jnahuel/Purity/03. Hardware/Generador de ozono/Images/Generador de ozono - Dorso.jpg

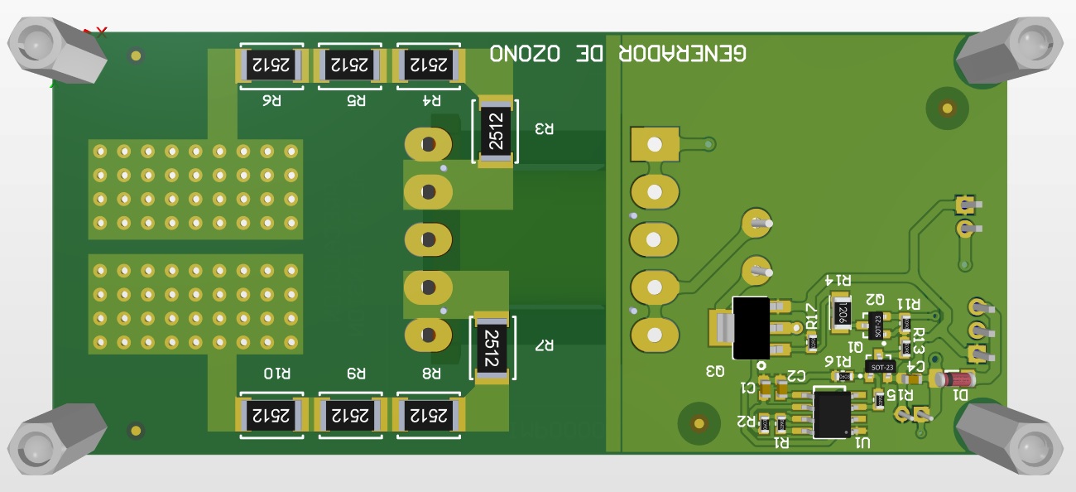
03. Hardware/Generador de ozono/Images/Generador de ozono - Dorso.jpg
