jnahuel/Purity/03. Hardware/Generador de ozono/Images/Generador de ozono - Frente.jpg

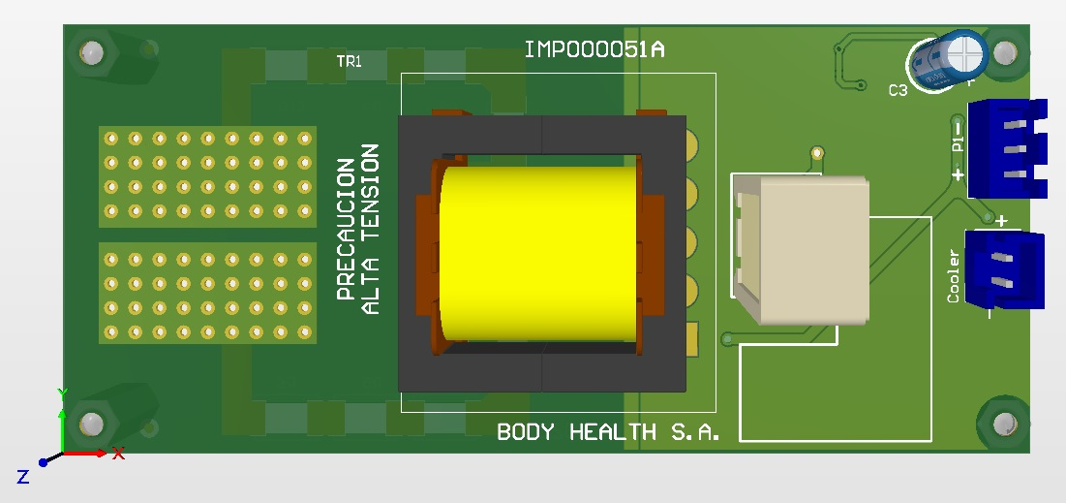
03. Hardware/Generador de ozono/Images/Generador de ozono - Frente.jpg
