jnahuel/Purity/01. Description/Medición de la generación de ozono.pdf

## Medición de la generación de ozono

Para poder calibrar la generación de ozono en los equipos Purity, se estableció el siguiente setup:

- Cavidad cerrada de 35cm x 35cm x 8,4cm. Contiene un volumen aproximado de 0,01m³
- Sensor de ozono “ULPSM-O3 968-046”
- Fuente de alimentación de 12V con 10W de potencia.
- Placa prototipo para generar ozono.

Por recomendaciones de la hoja de datos del sensor, se lo debe dejar precalentar 1 hora en el ambiente donde se realizará la medición, el cuál debe estar libre del gas a medir. Pasado este tiempo, se accionó el generador de ozono y se dejó el sistema en estas condiciones por otra hora, antes de tomar la medición.
El valor de referencia para un ambiente libre de ozono es de 1,45V. Al cabo de 4 mediciones, se obtuvo un valor promedio de 1,8v en el pin de salida del sensor. Esto significa una diferencia de 0,35v respecto de la referencia de tensión para un ambiente libre del gas en cuestión. La sensibilidad típica del sensor utilizado es de 30mV/PPM, con un valor mínimo de 15mV/PPM. Se tomará éste último como el valor del dispositivo, ya que arrojaría la peor condición posible. Por lo tanto, se tiene que:

# SSSSSSSSSSSSSSSSSSSSSSSS mmí mm mmmm = 15mmmm/PPPPPP DD DD DD mm = 350mmmm

Con lo que la concentración dentro de la caja de medición será de:

# CC CC ó mmáxx = DD DD DD mm SSSSSSSSSSSSSSSSSSSSSSSS mmí mm mmmm CC CC ó mmáxx = 350mmmm 15mmmm/PPPPPP CC ó mmáxx cc = 23PPPPPP

Para el peso molecular del gas ozono (48), se tiene la equivalencia

# 1PPPPPP = 1,96mmmm/mm3

Esto arroja que para el volumen de la caja, la cantidad de mili gramos producidos es:

# CC oo = 0,45mmmm

Contemplando el caso del ambiente standard para el cual está pensado el Purity, de 130mm3,

arroja una concentración de:

CC CC ó mmáxx | = 0,45mmmm 130mm3
CC CC ó mmáxx | = 0,0035 mmmm mm3

O, lo que es lo mismo:

# CC CC ó mmáxx = 0,00178PPPPPP

En conclusión, la máxima dosis de ozono que el equipo Purity es posible de generar, se encuentra muy por debajo del límite indicado por la TLV de 0,1PPM, para exposiciones prolongadas de 8 horas diarias. Por lo tanto, se concluye la seguridad de las personas presentes en el ambiente de trabajo del dispositivo.

Por otro lado, se observó que pasado un tiempo de 5’, en todas las mediciones, el sensor volvió a indicar el valor del ambiente previo a la contaminación por ozono, demostrando que es un gas inestable que no genera permanencia en el ambiente.
