jnahuel/Purity/02. Hospital/Comparation.pdf

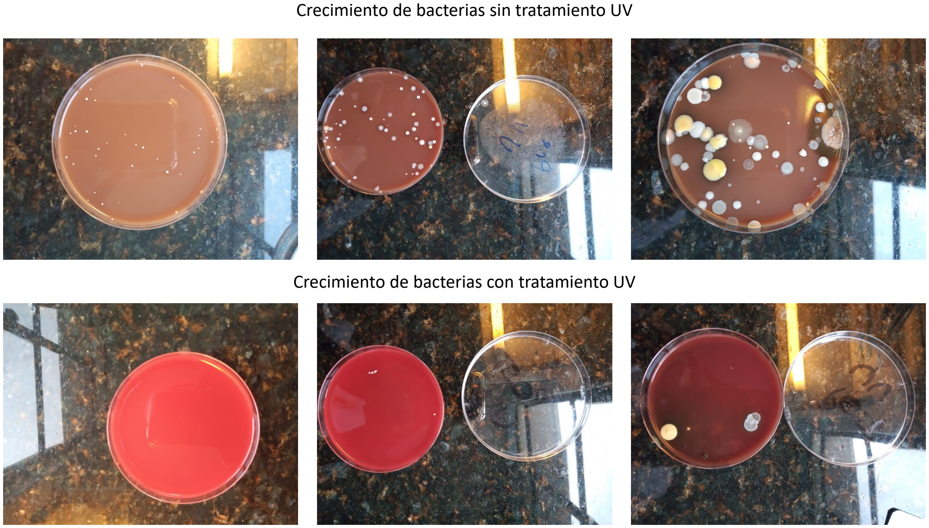
[picture p16: page 1]

Crecimiento de bacterias sin tratamiento UV

Crecimiento de bacterias con tratamiento UV

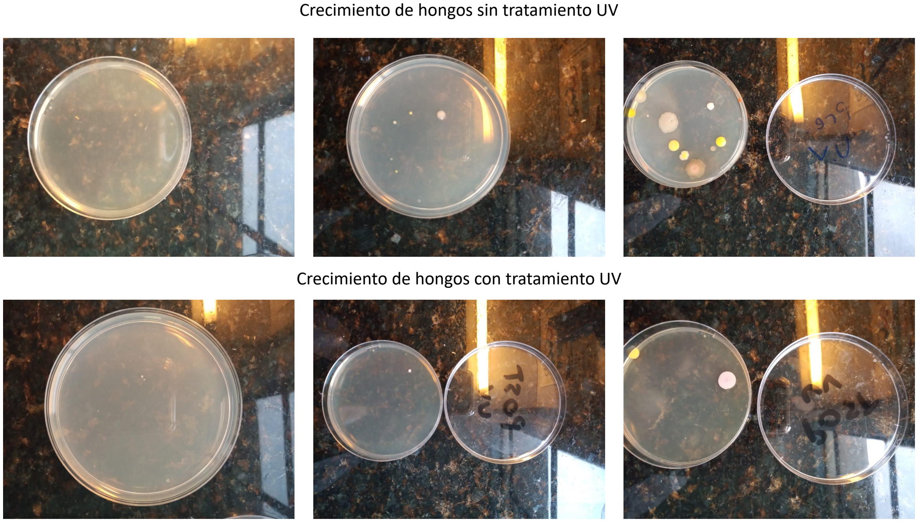
[picture p17: page 2]

Crecimiento de hongos sin tratamiento UV

Crecimiento de hongos con tratamiento UV
