jnahuel/Purity/03. Hardware/Display_Control_UV/Images/Display_Control_UV - 3D.jpg

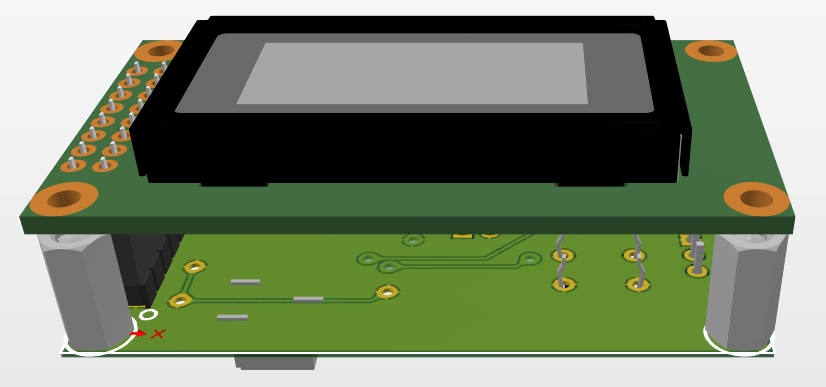
03. Hardware/Display_Control_UV/Images/Display_Control_UV - 3D.jpg
