jnahuel/Purity/03. Hardware/Generador de ozono/Images/Generador de ozono - 3D.jpg

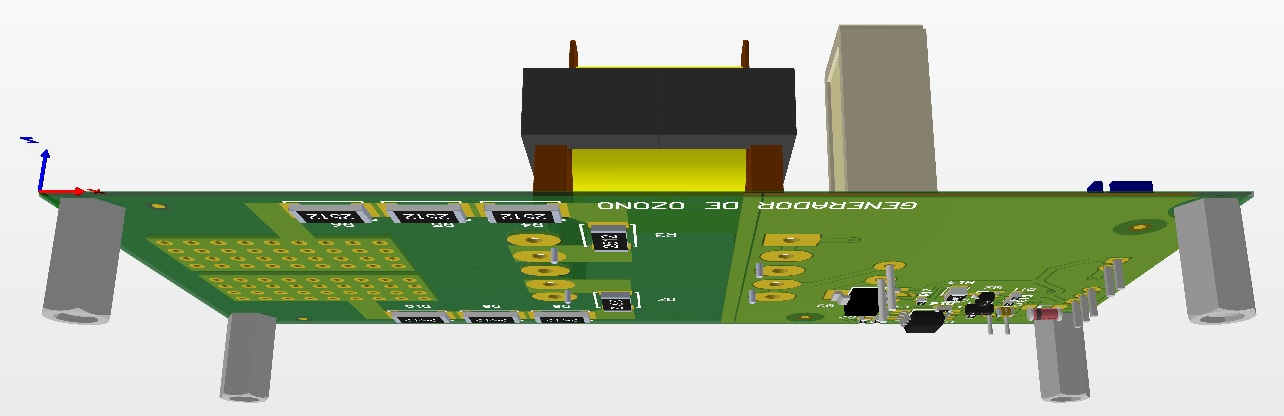
03. Hardware/Generador de ozono/Images/Generador de ozono - 3D.jpg
