jnahuel/Purity/03. Hardware/Display_Control_UV/Project Outputs for Display_Control_UV/Display_Control_UV.xlsx

Quantity | Designator | Value | Cod.DigiKey | Description | Comment | Fabricante | Cod.Fabricante | Footprint
2 | Balastro, Tubo |  | 450-1650-ND | Ejemplo | Boton para placa | TE Connectivity ALCOSWITCH Switches | 1825910-6 | TactButton
3 | C1, C2, C3 | 100nF | 399-7845-1-ND | CAP CER 0.1UF 50V X7R 0603 | 100nF | KEMET | C0603C104M5RACTU | C_0603
1 | D1 | FDLL4148 | FDLL4148CT-ND | DIODE GEN PURP 100V 200MA LL34/SOD80/MINI MELF | FDLL4148 | ON Semiconductor | FDLL4148 | SOD-80/MLL34
1 | J1 |  | S2011EC-03-ND | CONN HEADER VERT 6POS 2.54MM | DBM | Sullins Connector Solutions | PRPC003DAAN-RC | DBM
1 | OLED1 |  | S2011EC-08-ND | Header para la placa 8x2 OLED Character Display | OLED-08x02-4soportes | Sullins Connector Solutions | PRPC008DAAN-RC | OLED-ZocaloDoble
1 | OLED_BOM1 |  | - | 8x2 OLED Character Display | OLED-8x2-BOM | Winstar | WEH000802A-BPP5N0 | OLED-08x02-4soportes | <-- Por ahora se coloca en Body
1 | OLED_HEADER_BOM1 |  | S7111-ND | Header 8x2 | OLED-8x2-Header-BOM | Sullins Connector Solutions | PPPC082LFBN-RC
1 | P1 |  | 455-2248-ND | CONN HEADER XH TOP 3POS 2.5MM | IN_VCC | JST Sales America Inc. | B3B-XH-A(LF)(SN) | B3B-XH-A_3D
3 | R1, R3, R4 | 10K | 311-10KGRCT-ND | RES SMD 10K OHM 5% 1/10W 0603 | 10K | Yageo | RC0603JR-0710KL | R_0603
1 | R2 | 5K | 3361P-502GLFCT-ND | TRIMMER 5K OHM 0.5W GW TOP ADJ | 5K | Bourns Inc. | 3361P-1-502GLF | Preset_SMD
1 | U1 | MC9S08PA32AVLCR-32 | 568-15175-1-ND | S08 Microcontroller IC 8-Bit 20MHz 32KB (32K x 8) FLASH 32-LQFP (7x7) | MC9S08PA32AVLCR-32 | NXP | MC9S08PA32AVLCR | QFP7x7
1 | U2 |  | MC78M05BDTRKGOSCT-ND | IC REG LINEAR 5V 500MA DPAK | MC78M05 | ON Semiconductor | MC78M05BDTRKG | TO-252AA_N
