jnahuel/Purity/03. Hardware/Generador de ozono/Project Outputs for Generador de ozono/Generador de ozono.xls

Cod.Digikey | Cod.Fabricante | Description | Designator | Quantity
 | IMP000051A | Circuit Board, 2 Layers with mask and silk | BOM1 | 1
399-9042-1-ND | C0603C222M5RACTU | CAP CER 2200PF 50V X7R 0603 | C1 | 1
399-7842-1-ND | C0603C103M5RACTU | CAP CER 10000PF 50V X7R 0603 | C2 | 1
493-1058-ND | UVR1E220MDD | CAP ALUM 22UF 20% 25V RADIAL | C3 | 1
399-7845-1-ND | C0603C104M5RACTU | CAP CER 0.1UF 50V X7R 0603 | C4 | 1
455-2247-ND | B2B-XH-A(LF)(SN) | CONN HEADER XH TOP 2POS 2.5MM | Cooler | 1
FDLL4148CT-ND | FDLL4148 | DIODE GEN PURP 100V 200MA LL34/SOD80/MINI MELF | D1 | 1
 |  | Pad para terminar un camino - No es un componente | J1, J2 | 2
455-2248-ND | B3B-XH-A(LF)(SN) | CONN HEADER XH TOP 3POS 2.5MM | P1 | 1
MMBT2907A-FDICT-ND | MMBT2907A-7-F | TRANS PNP 60V 0.6A SOT23-3 | Q1 | 1
MMBT2222A-FDICT-ND | MMBT2222A-7-F | TRANS NPN 40V 0.6A SMD SOT23-3 | Q2 | 1
1727-5084-6-ND | PBHV8215Z,115 | TRANS NPN 150V 2A SOT223 | Q3 | 1
311-10KGRCT-ND | RC0603JR-0710KL | RES SMD 10K OHM 5% 1/10W 0603 | R1, R11, R13, R15, R16, R17 | 6
311-100KGRCT-ND | RC0603JR-07100KL | RES SMD 100K OHM 5% 1/10W 0603 | R2 | 1
118-CHV2512-JW-105ELFCT-ND | CHV2512-JW-105ELF | 1 MOhms ±5% 1W Chip Resistor 2512 (6432 Metric) High Voltage Thick Film | R3, R4, R5, R6, R7, R8, R9, R10 | 8
A102188-ND | SQMW515RJ | 15 Ohms ±5% 5W Through Hole Resistor Radial | R12 | 1
RHM220ICT-ND | ESR18EZPJ221 | 220 Ohms ±5% 0.5W, 1/2W Chip Resistor 1206 | R14 | 1
- | TRF000XXX Transformador alta tension | Transformador RF | TR1 | 1 | <-- Por ahora se coloca en Body
296-6501-1-ND | NE555DR | IC OSC SGL TIMER 100KHZ 8-SOIC | U1 | 1
