jnahuel/Purity/(list of files, cad)

Other CAD files:
04. Software/Control_Display_UV/FLASH/Sources/main_c.obj
04. Software/Control_Display_UV/FLASH/Generated_Code/IO_Map_c.obj
04. Software/Control_Display_UV/FLASH/Project_Settings/Startup_Code/start08_c.obj
04. Software/Control_Display_UV/FLASH/Generated_Code/Cpu_c.obj
04. Software/Control_Display_UV/FLASH/Sources/Events_c.obj
04. Software/Control_Display_UV/FLASH/Generated_Code/Vectors_c.obj
04. Software/Control_Display_UV/FLASH/Generated_Code/Vtpm3ovf_c.obj
