jnahuel/Purity/07. Manuals and labels/Purity UV - Sticker.pdf

## OZONO-UV

## 100mm x 55mm papel autoadhesivo blanco

220V~
50/60 Hz

### 40 W CLASE I

BODY HEALTH S.A.
Belgrano 2668, Don Torcuato,
Bs As, Argentina.

### Tel.: (+54) 11 4727 4747 Email: info@bodyhealthgroup.com www.bodyhealthgroup.com

IMPORTANTE PARA EL USUARIO: Este equipo posee fichas de 3 espigas planas con toma a tierra para aumentar la seguridad. NO LAS ELIMINE colocando un adaptador o reemplazándola por otra de 2 espigas. PARA SU SEGURIDAD. Su instalación debe estar prevista de conductor de tierra. De no ser así, realice la adecuación con personal especializado.

SN
