jnahuel/Purity/07. Manuals and labels/Purity UV - Manual.docx.pdf

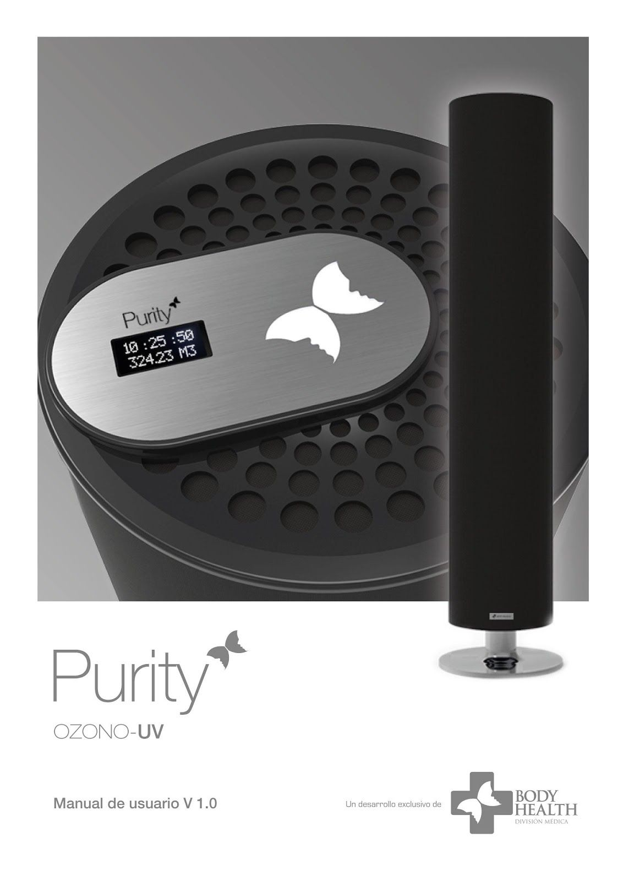
[picture p23: page 1]

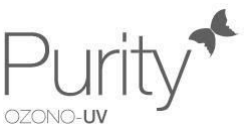
[picture p24: figure]

# Manual de usuario

### ¿Desea saber más? ¿Quiere conocer otros equipos de Body Health? Infórmese en www.bodyhealthgroup.com

### Dirección del Fabricante: Body Health SA Gral. Belgrano 2668 DON TORCUATO C.P. 1611 – BUENOS AIRES - ARGENTINA TEL: (+54) 11 4727 4747 Email: info@bodyhealthgroup.com www.bodyhealthgroup.com

2

# ÍNDICE

Información de Seguridad | 4
Diseño y funcionamiento | 5
Display | 6
Cambio de tubo | 7
Solución de Problemas | 8
Especificaciones Técnicas | 8
Información de Garantía | 9

3

# INFORMACIÓN DE SEGURIDAD

IMPORTANTE: Por favor lea, comprenda y cumpla con todas las instrucciones proporcionadas en este manual antes de usar el aparato. El incumplimiento de las instrucciones dadas en este manual y/o el uso del dispositivo en formas que no sean las mencionadas en este manual puede resultar en lesión grave y/o daño al producto.

- NO opere la unidad si el cable o el enchufe están dañados. El hacerlo puede ocasionar daños a la unidad

o lesiones.

- NO coloque el cable de corriente debajo de la alfombra. No cubra el cable con tapetes, alfombras,

tapices o cubiertas similares. NO COLOQUE EL CABLE DEBAJO DE MUEBLES O ELECTRODOMÉSTICOS. Coloque el cable de corriente lejos de áreas de mucho tráfico.

- Solo use el purificador de aire como se describe en este manual.
- NO manipule la unidad con las manos mojadas. Seque bien las manos antes de manipular cualquier

parte del purificador de aire.

- NO desenchufe el purificador de aire tirando del cable. Hacerlo puede provocar chispas eléctricas o

incendios. Desenchufe la unidad agarrando y jalando el enchufe.

- NO use un cable de extensión con esta unidad.
- Coloque el purificador de aire de manera que el cable de corriente llegue fácilmente a una toma de

corriente estándar.

- NO coloque el purificador de aire cerca de fuentes de calor, como estufas, hornos, radiadores o

computadoras.

- Desenchufe el aparato de la red eléctrica antes de realizar el mantenimiento.
- Esta unidad debe limpiarse con frecuencia.
- NO use el purificador de aire al aire libre o en superficies mojadas.
- NO use el purificador de aire en un espacio cerrado donde haya gases inflamables, combustibles o

explosivos.

- Es importante mantener todos los objetos lejos de la parrilla de entrada de aire.
- Coloque el purificador de aire sobre una superficie plana, sólida y estable. Nunca coloque la unidad

sobre superficies blandas, como una cama o un sofá.

4

# DISEÑO Y FUNCIONAMIENTO

El sistema PURITY OZONO-UV es una tecnología que permite visualizar en una pantalla OLED, el recuento de horas de uso y el volumen de aire procesado. A través de la cámara central cerrada, ingresa un flujo de aire, que será expuesto a la radiación ultravioleta de mayor poder germicida, y a una dosis específica de ozono (O3) capaz de destruir aquellos microorganismos más difíciles de eliminar. A su vez, ese volumen de aire, será expulsado por la parte superior del equipo, a una temperatura levemente superior a la de ingreso, generando una rotación continua y logrando un mayor alcance.
La presentación del volumen procesado se actualizará cada 5 segundos.
Cuando resten menos de 50 horas para agotar la vida útil del tubo UV, el equipo mostrará a cada hora una indicación para reemplazarlo. Si se extingue el tiempo, el sistema dejará de funcionar y se indicará que debe cambiarse el tubo UV.

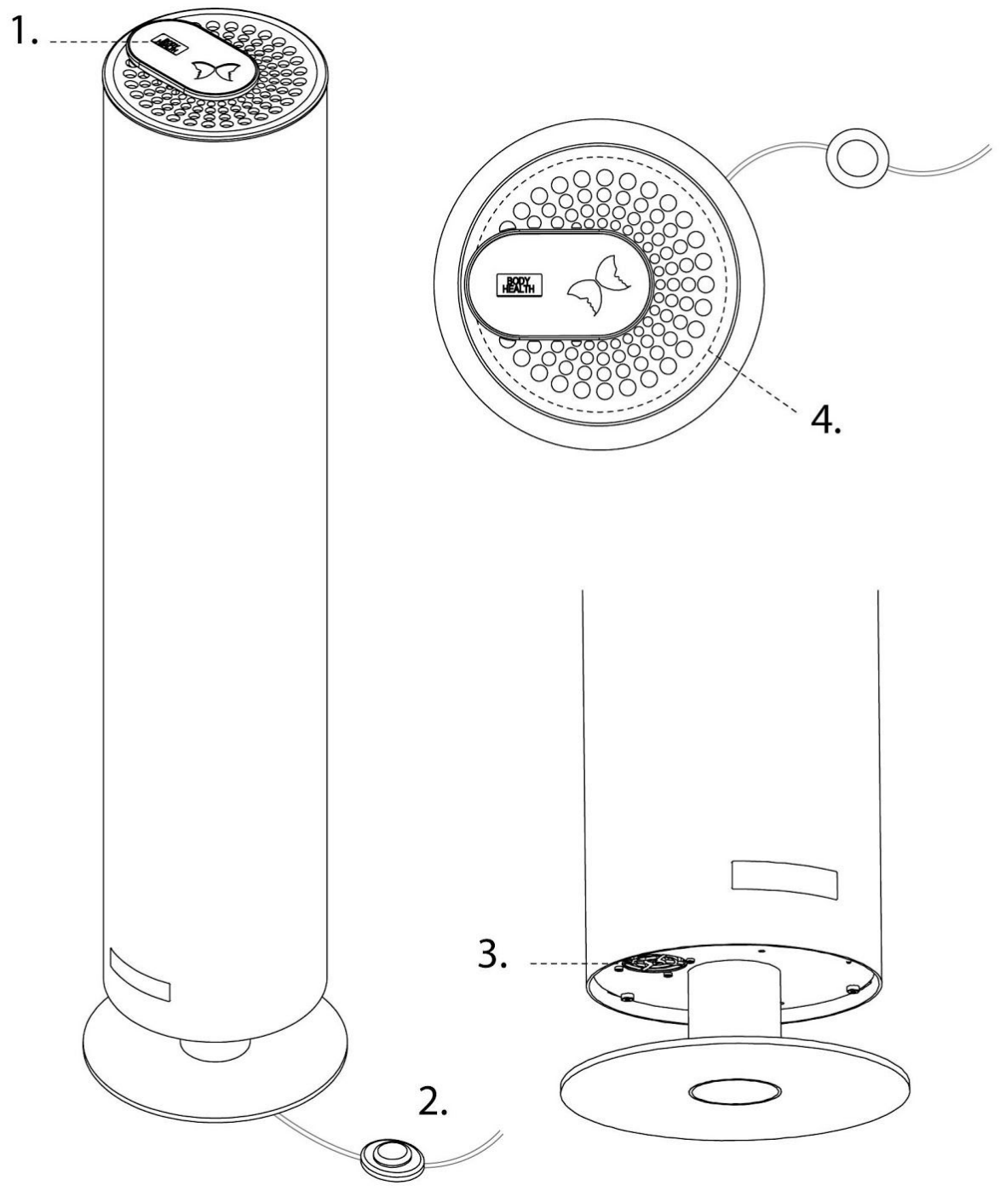
[picture p25: figure]

### 1. Display OLED 2. Interruptor Encendido/Apagado 3. Cooler (entrada de aire) 4. Salida de aire

5

# DISPLAY

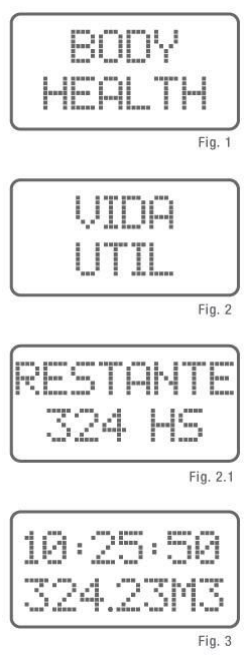
[picture p26: figure]

## FIG 1. Pantalla de bienvenida / funcionamiento

## FIG 2 / 2.1. Indicador de vida útil de tubo

## FIG 3. Contador de horas en el último uso / Volumen de aire procesado

El conteo se reinicia en cada encendido.
El volumen procesado se actualiza cada 5 segundos.

6

# CAMBIO DE TUBO

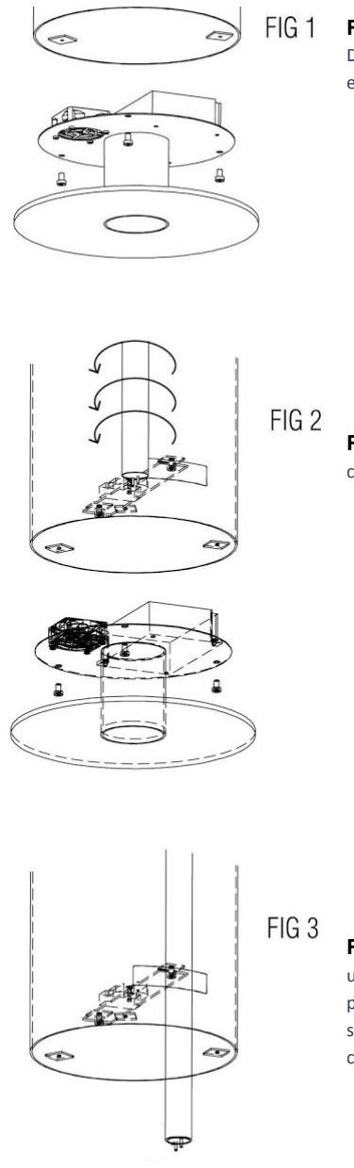
[picture p27: figure]

FIG 1.. Desconectar la alimentación de la red eléctrica.

### Desmontar el cuerpo, sacando los 3 tornillos que se

encuentran en la base inferior.

### FIG 2. Rotar 90° para desacoplar el tubo del zócalo, en

cualquier dirección.

### FIG 3. Retirar el tubo por la parte inferior y reemplazarlo por

### uno nuevo. Para volver a armar el equipo repetir el procedimiento de manera inversa. Se debe despegar la tapa superior del equipo, y mantener presionado el botón indicado

como “Tubo”, para volver a cero las horas consumidas.

7

# SOLUCIÓN DE PROBLEMAS

Problema | Causa | Solución
La unidad no funciona. | El enchufe no está conectado. | Inserte el enchufe en una toma de corriente.
| Toma de corriente defectuosa. | Prueba con otra toma de corriente.
| Enciende el display pero no enciende el tubo UV | Comuníquese con servicio técnico
| Enciende el tubo UV pero no enciende el display | Comuníquese con servicio técnico
| El display indica “REEMPLAZAR TUBO” | Se debe cambiar el tubo UV por uno nuevo, y volver a cero las horas consumidas del mismo.
Ruido inusual. | Objeto extraño dentro de la unidad. | Comuníquese con servicio técnico
| Cooler sucio. | Remover suciedad

# ESPECIFICACIONES TÉCNICAS

Fuente de poder | AC 220-240V 50/60Hz
Consumo de energía | 40 W
Área aplicable | ≤ 30 m²
Temperatura y condiciones de funcionamiento | Temperatura: -10ºC ~ 55ºC Humedad: ≤95%RH

8

# INFORMACIÓN DE GARANTÍA

### 7. GARANTIA

7.1. BODY HEALTH S.A. es el fabricante y garantiza al cliente (usuario final) que el producto al que se refiere esta garantía estará libre de defectos de fabricación y de mano de obra por el término de UN (1) AÑO, contando desde la fecha de compra del producto por parte del usuario final original al fabricante, a un distribuidor o comercializador debidamente autorizado por BODY HEALTH S.A.
7.2. La presente garantía esta exclusivamente referida a defectos de fabricación y/o vicios de material que afecten el normal funcionamiento del producto y aquellos defectos que surgieren como resultado del uso normal del producto.-
7.3. Esta garantía limitada no cubre los defectos que se deriven de:
a. Mantenimiento inapropiado o inadecuado, alteración o reparación realizada por personal no autorizado por BODY HEALTH S.A.;
b. Uso de accesorios, soportes, suministros y/o cualquier otro elemento no suministrados por BODY HEALTH S.A.
c. Modificaciones no autorizadas, uso indebido, negligente o inadecuado (incluyendo la falta de mantenimiento razonable y necesario);
d. Lugar de uso y mantenimiento inapropiados;
e. Daños, roturas, golpes, caídas o rayaduras causadas durante el traslado y/o envio del producto; o
f. Causas no atribuibles a defectos de fabricación y/o materiales;
g. Caso fortuito o fuerza mayor;
h. Exceso o caídas de tensión eléctrica que impliquen uso en condiciones anormales;
i. Los daños o fallas ocasionadas por deficiencias, sobretensiones, descargas o interrupciones del circuito de alimentación eléctrica o rayos, deficiencias en la instalación eléctrica del domicilio del usuario o conexión del artefacto que no sean las especificadas en el manual;
j. Enmiendas o raspaduras en los en los datos del certificado de garantía o factura de compra;
k. Los daños ocasionados por inundaciones, terremotos, incendios, tormentas eléctricas, golpes o accidentes de cualquier naturaleza. Esta enumeración no es de carácter taxativos, quedando excluidos de la presente garantía todos aquellos supuestos en los que, en términos generales el funcionamiento anormal del producto se deba a causas que no sean directa o exclusivamente atribuibles a BODY HEALTH S.A.; o
l. Cualquier violación de las condiciones de uso, instalación y mantenimiento necesarias especificadas en el Manual de Uso;
Las prestaciones que constituyen la obligación de BODY HEALTH S.A. bajo la presente garantía se limitan a la reparación, reemplazo de la o las piezas que correspondan y la mano de obra que resulte necesaria a tales efectos.-
7.3. Si el cliente (usuario final), durante el periodo de garantía, pusiera en conocimiento a BODY HEALTH S.A. la existencia de los defectos definidos anteriormente, BODY HEALTH S.A. podrá, según prefiera reparar o reemplazar el producto si estuviera averiado. Cualquier producto de reemplazo será nuevo o como nuevo. En caso que al momento del reemplazo no hubiera disponible un producto idéntico al reemplazado (ya sea por discontinuación de su producción, falta de stock o por cualquier otra causa), BODY HEALTH S.A. se reserva el derecho de suministrador un producto de presentaciones o funcionalidad por lo menos iguales a las del producto reemplazado. SI luego de un plazo razonable, no fuese posible para BODY HEALTH S.A. reparar o reemplazar el producto, el cliente tendrá derecho, como única compensación, al reintegro del precio de compra, contra la devolución del producto a BODY HEALTH S.A.
7.4. BODY HEALTH S.A. se reserva el derecho de modificar el producto sin previo aviso y utilizar repuestos legítimos sustitutos que cumplan las mismas funciones en reparación de grarantia.-
7.5. Exceptuando las obligaciones expuestas en este certificado de garantía, bajo ninguna circunstancias BODY HEALTH S.A. será responsable de cualquier daño directo o indirecto (incluyendo sin limitación perdida de datos o lucro cesante) o por cualquier daño o perjuicio que sea a consecuencia directa, indirecta o remota del uso o mal funcionamiento del producto y/o mala o incorrecta instalación del producto, cualquiera que sea el fundamento del reclamo (contractual, extracontractual o legal).
7.6. Se le cobrara el coste de examinar una unidad que no necesite reparación (incluyendo los gastos de envio resultantes) o por reparaciones necesarias que no estén cubiertas por la garantía limitada.-
7.7. Para validar su garantía deberá contactarse con BODY HEALTH S.A. y/o su distribuidor autorizado y proporcionar la factura de compra original u otra prueba de compra del producto y de la fecha de compra. No se aceptaran devoluciones del producto sin aceptación previa de BODY HEALTH S.A. o del distribuidor correspondiente. Las reparaciones se realizaran únicamente por BODY HEALTH S.A. o autorizado. Una reparación en garantía no autorizada anulara la garantía y se realizara bajo su propia responsabilidad.-
7.8. La presente garantía tiene validez exclusivamente en la República Argentina.-
7.9. Ni BODY HEALTH S.A., ni ninguna entidad o personal directa o indirectamente vinculada o relacionada con BODY HEALTH S.A.:
a. Ofrecen ninguna otra garantía de ninguna índole, expresa o implícita, oral o escrita, respecto al producto que se refiere esta garantía;
b. Formulan ninguna garantía implícita de comercialización o adecuación del producto para un propósito determinado.
El presente certificado se ajusta a la Ley 24240 y su decreto reglamentario 1798/94, anula cualquier otra garantía implícita o explícita.-

BODY HEALTH S.A.
Belgrano 2668
CP 1611 Don Torcuato, Tigre, Buenos Aires, Argentina

9
