jnahuel/Purity/05. Cables/MAZ000141.pdf

## COCon?D

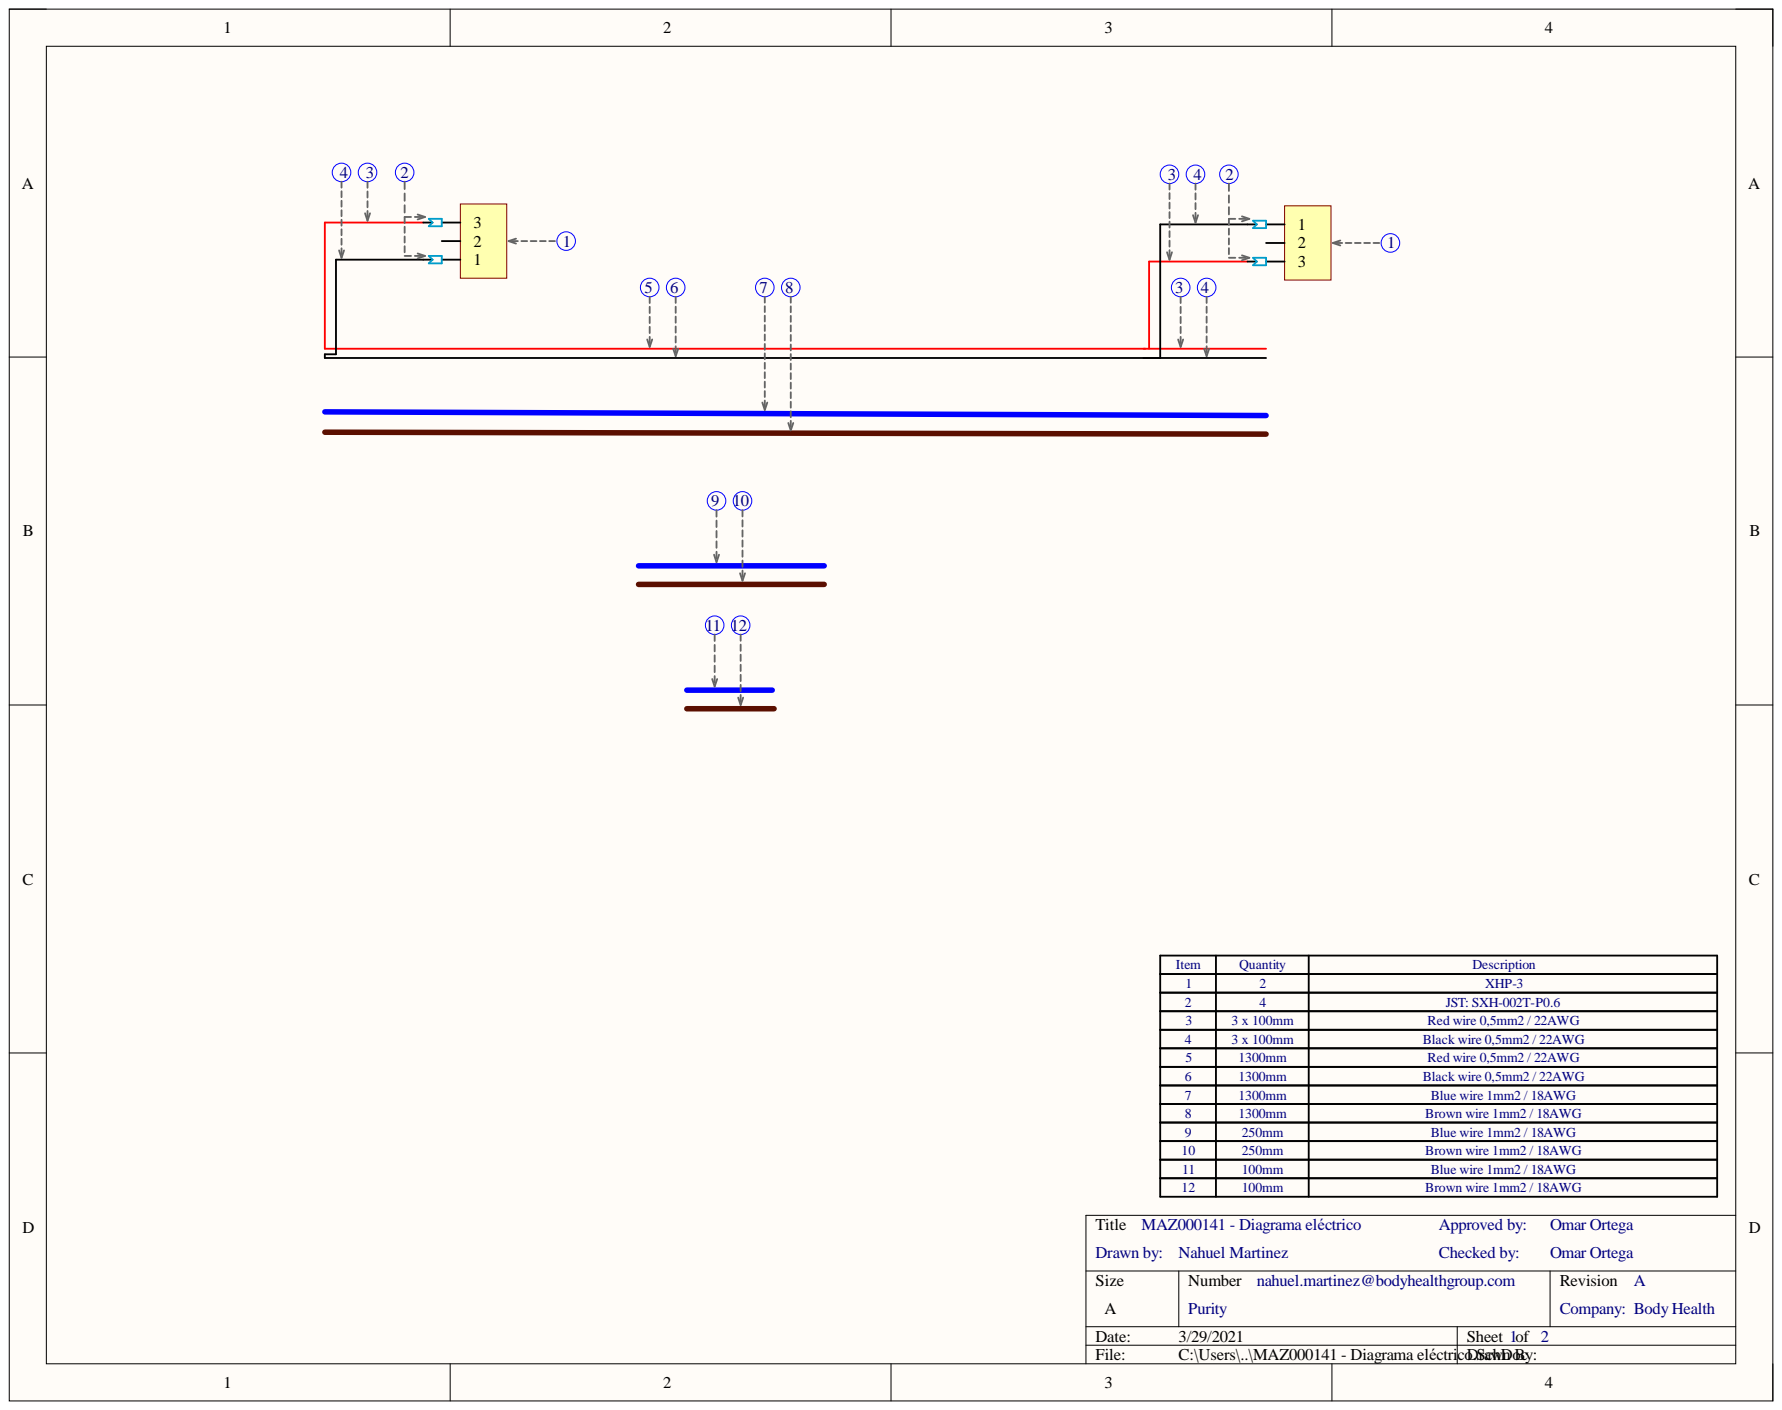
[picture p28: page 1]
Title; Size; Number; Revision; Date:; Sheet of; File:; C:\Users\..\MAZ000141 - Diagrama eléctricoDr.ScawhDon Bcy:; MAZ000141 - Diagrama eléctrico; Nahuel Martinez; Drawn by:; Checked by:; Omar Ortega; Approved by:; Purity; Company: Body Health; PICon?01 PICon?02 PICon?03; PICon?01; PICon?02; PICon?03; PISoc?00 PISoc?01; COCon?C COSoc?B; PISoc?01 PISoc?00; COSoc?A; COTer?

Item | Quantity | Description
COZoc1 1 | 2 | XHP-3

2 | 4 | JST: SXH-002T-P0.6
3 | 3 x 100mm | Red wire 0,5mm2 / 22AWG
4 | 3 x 100mm | Black wire 0,5mm2 / 22AWG
5 | 1300mm | Red wire 0,5mm2 / 22AWG
6 | 1300mm | Black wire 0,5mm2 / 22AWG
7 | 1300mm | Blue wire 1mm2 / 18AWG
8 | 1300mm | Brown wire 1mm2 / 18AWG
9 | 250mm | Blue wire 1mm2 / 18AWG
10 | 250mm | Brown wire 1mm2 / 18AWG
11 | 100mm | Blue wire 1mm2 / 18AWG
COZoc? 12 | 100mm | Brown wire 1mm2 / 18AWG

nahuel.martinez@bodyhealthgroup.com

## COCon?B COCon?A

## COTer1

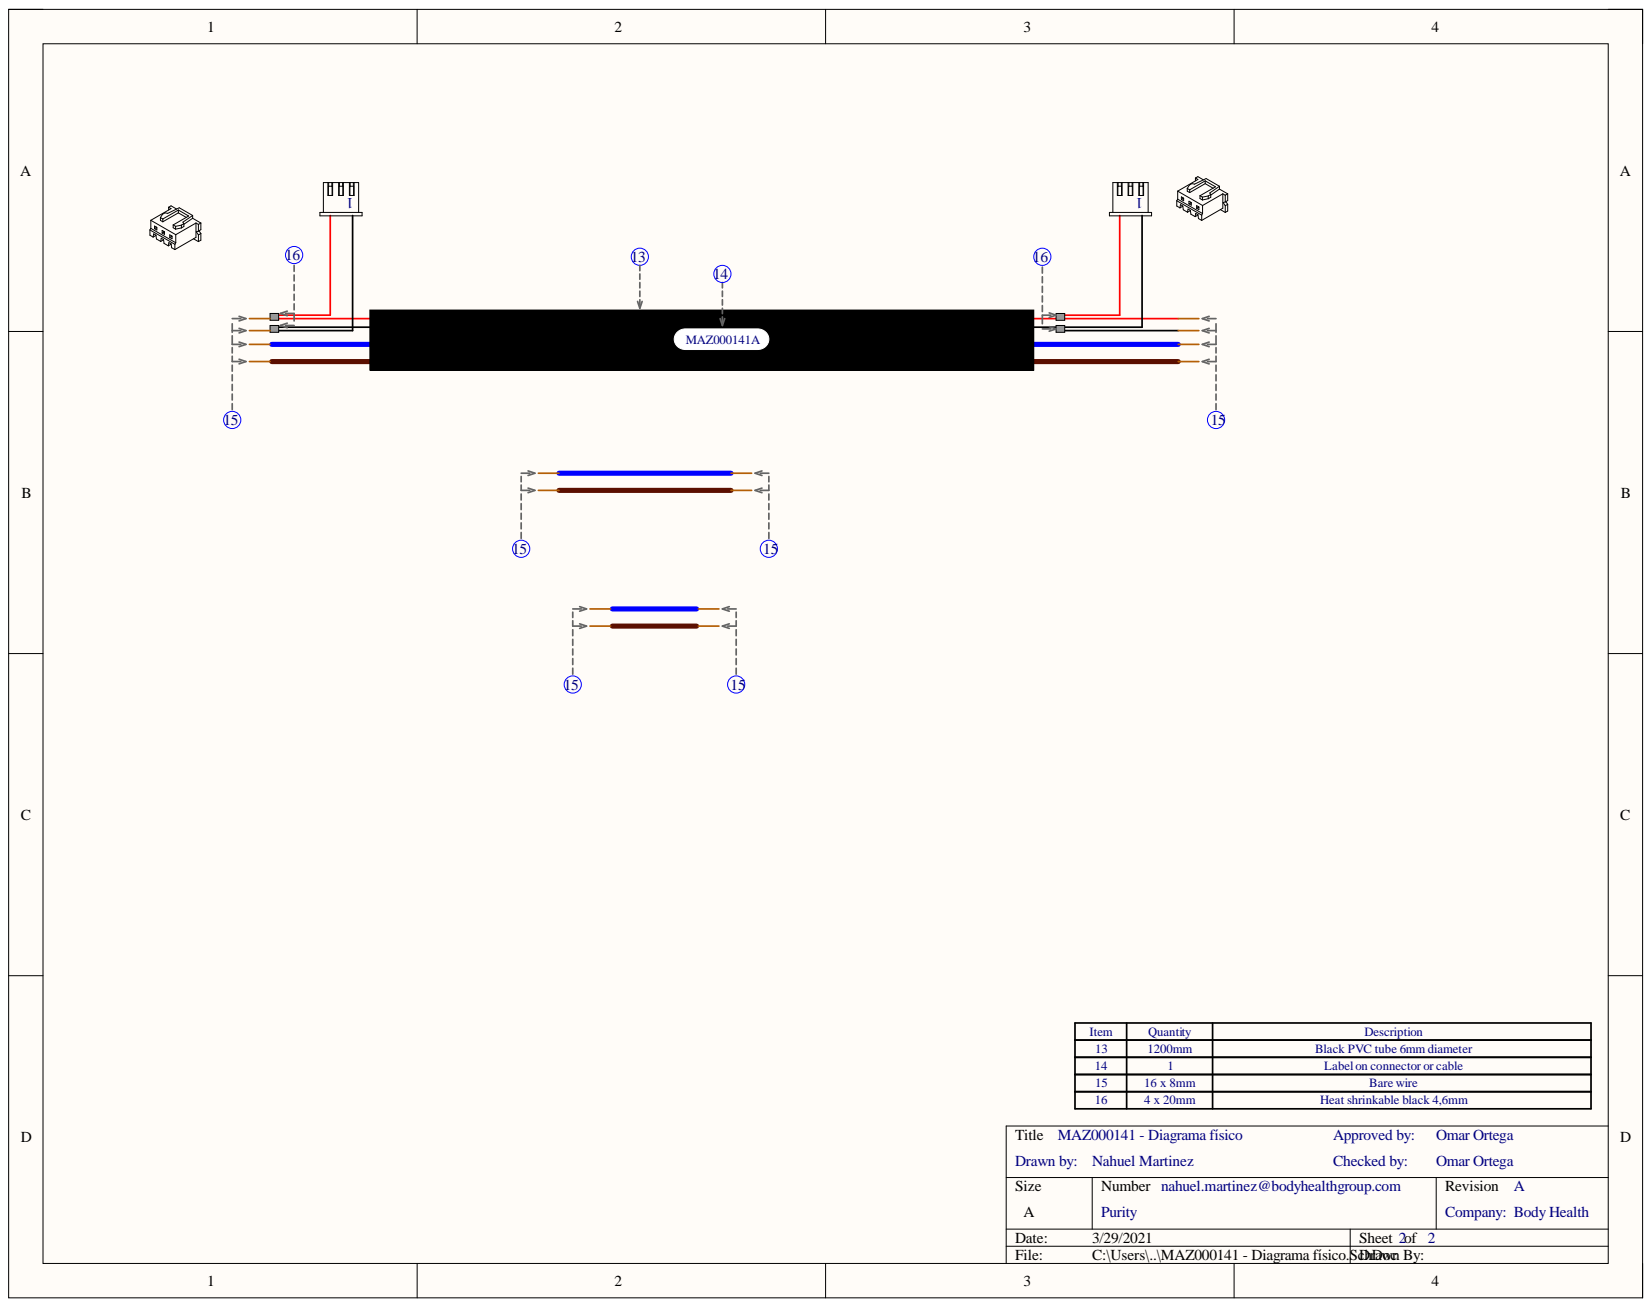
[picture p29: page 2]
Title; Size; Number; Revision; Date:; Sheet of; File:; C:\Users\..\MAZ000141 - Diagrama físico.ScDrhDoawcn By:; MAZ000141 - Diagrama físico; Nahuel Martinez; Drawn by:; Checked by:; Omar Ortega; Approved by:; Purity; Company: Body Health; MAZ000141A; COEti2; COTer?

Item | Quantity | Description
COZoc1 13 | 1200mm | Black PVC tube 6mm diameter
COZoc? 14 | 1 | Label on connector or cable
15 | 16 x 8mm | Bare wire
16 | 4 x 20mm | Heat shrinkable black 4,6mm

nahuel.martinez@bodyhealthgroup.com
