jnahuel/Purity/(list of files, drawings)

Other design files:
03. Hardware/Display_Control_UV/Display_Control_UV.PcbDoc
03. Hardware/Display_Control_UV/Display_Control_UV.PrjPcb
03. Hardware/Display_Control_UV/Display_Control_UV.SchDoc
03. Hardware/Generador de ozono/Generador de ozono.PcbDoc
03. Hardware/Generador de ozono/Generador de ozono.PrjPcb
03. Hardware/Generador de ozono/Generador de ozono.SchDoc
05. Cables/MAZ000141 - Diagrama eléctrico.SchDoc
05. Cables/MAZ000141 - Diagrama físico.SchDoc
